CWRU-High-energy-Astrophysics-Lab/Auger_ekit/pmt-socket/DDP_pont1.xls

Sheet: Pont XP1805_D1 et sonde
Appareils utilisés |  |  | Résistance interne en Mohms | Résistance interne en Mohms | Impédance équivalente avec les 2 appareils en mohms
Multimètre Tektronix DMM916 |  |  | 10 | 10 | 75.074
Sonde Haute Tension Fluke 80K-6 |  |  | 75 | 75
Mesure sur dynodes | Résistance inter- dynodes en Mohms |  | Résistance appliquée sur les dynodes en Mohms | Résistance équivalente en Mohms avec sonde HT 80K-6 et multimètre 10Mohms | Résistance totale équivalente en Mohms | Courant parcouru dans le pont diviseur en µA | Potentiel à trouver en volts | U réel en volts | Sur schéma | Repère
K | 8.6499 |  | 0.0000 | 0.0000 | 25.4959 | 78.444 | 0.00 | 0.00 | 0 | K
G1 |  | 0.182 | 8.6499 | 7.7562 | 24.6022 | 81.293 | 630.53 | 678.53 | 678.5326268 | G1
D1 | 0.866 |  | 8.8319 | 7.9023 | 24.5663 | 81.412 | 643.34 | 692.81 | 692.8094321 | D1
G2 |  | 2.6 | 9.6979 | 8.5885 | 24.3865 | 82.013 | 704.36 | 760.74 | 760.7419232 | G2
D2 | 1.1 |  | 12.2979 | 10.5669 | 23.7649 | 84.158 | 889.29 | 964.70 | 964.6962845 | D2
D3 |  | 1.1 | 13.3979 | 11.3690 | 23.4670 | 85.226 | 968.93 | 1050.98 | 1050.984668 | D3
D4 | 1.3 |  | 14.4979 | 12.1513 | 23.1493 | 86.396 | 1049.82 | 1137.27 | 1137.273052 | D4
D5 |  | 2 | 15.7979 | 13.0515 | 22.7495 | 87.914 | 1147.41 | 1239.25 | 1239.250232 | D5
D6 | 2.2 |  | 17.7979 | 14.3871 | 22.0851 | 90.559 | 1302.88 | 1396.14 | 1396.138203 | D6
D7 |  | 2.6 | 19.9979 | 15.7915 | 21.2895 | 93.943 | 1483.50 | 1568.71 | 1568.71497 | D7
D8 | 2.4 |  | 22.5979 | 17.3696 | 20.2676 | 98.680 | 1714.03 | 1772.67 | 1772.669331 | D8
A |  | 0.498 | 24.9979 | 18.7535 | 19.2515 | 103.888 | 1948.26 | 1960.93 | 1960.934895 | A
HT |  |  | 25.4959 | 19.0324 | 19.0324 | 105.084 | 2000.00 | 2000.00 | 2000 | HT
R total | 25.4959
Tension HT | 2000
Courant | 78.44

Sheet: Pont XP1805_D1
Mesure entre dynodes | Résistance en Mohms | Résistance équivalente en Mohms avec multimètre de 10Mohms | Résistance totale équivalente en Mohms | Courant parcouru dans le pont diviseur en µA | Différence de potentiel à trouver en volts | U réel en volts | Sur schéma | Repère
K - G1 | 8.6499 | 4.6380 | 21.4840 | 93.092 | 431.77 | 678.53 | 678.5326268 | G1
G1 - D1 | 0.182 | 0.1787 | 25.4926 | 78.454 | 14.02 | 14.28 | 692.8094321 | D1
D1 - G2 | 0.866 | 0.7970 | 25.4269 | 78.657 | 62.69 | 67.93 | 760.7419232 | G2
G2 - D2 | 2.6 | 2.0635 | 24.9594 | 80.130 | 165.35 | 203.95 | 964.6962845 | D2
D2 - D3 | 1.1 | 0.9910 | 25.3869 | 78.781 | 78.07 | 86.29 | 1050.984668 | D3
D3 - D4 | 1.1 | 0.9910 | 25.3869 | 78.781 | 78.07 | 86.29 | 1137.273052 | D4
D4 - D5 | 1.3 | 1.1504 | 25.3463 | 78.907 | 90.78 | 101.98 | 1239.250232 | D5
D5 - D6 | 2 | 1.6667 | 25.1626 | 79.483 | 132.47 | 156.89 | 1396.138203 | D6
D6 - D7 | 2.2 | 1.8033 | 25.0992 | 79.684 | 143.69 | 172.58 | 1568.71497 | D7
D7 - D8 | 2.6 | 2.0635 | 24.9594 | 80.130 | 165.35 | 203.95 | 1772.669331 | D8
D8 - A | 2.4 | 1.9355 | 25.0314 | 79.900 | 154.64 | 188.27 | 1960.934895 | A
A- HT | 0.498 | 0.4744 | 25.4723 | 78.517 | 37.25 | 39.07 | 2000 | HT
R total | 25.4959
Tension HT | 2000
Courant | 78.44
Mesure entre les condensateurs | Dynodes | Différence de potentiel en volts
C1 | D6-D4 | 258.8651509
C2 | D8-D6 | 376.5311285
C3 | A-D8 | 188.2655643
C4 | D7-D5 | 329.4647375
C5 | A-D7 | 392.2199256
C6 | A-Masse | 1960.934895
C7 | D8-Masse | 1772.669331
C8 | A-Masse | 1960.934895
C9 | A-Masse | 1960.934895
