CWRU-High-energy-Astrophysics-Lab/Auger_ekit/pmt-socket/Pont diviseur.xls

Sheet: Pont PHOTONIS XP1805_D1 V3
Tension maximum en volts | Courant maximum en µA | Résistance totale en Mohms
2000.0 | 80.0 | 25.0
Dynodes | Ratio | Repère résistance | Valeur résistance
K - G1 | 10.00 | R1à R7 | 8.711
G1 - D1 | 0.20 | R8 | 0.174
D1 - G2 | 1.00 | R9 | 0.871
G2 - D2 | 3.00 | R10+R11 | 2.613
D2 - D3 | 1.25 | R12 | 1.089
D3 - D4 | 1.25 | R13 | 1.089
D4 - D5 | 1.50 | R14 | 1.307
D5 - D6 | 2.25 | R15+R16 | 1.960
D6 - D7 | 2.50 | R17+R18 | 2.178
D7 - D8 | 3.00 | R19+R20 | 2.613
D8 - A | 2.75 | R21+R22 | 2.395
A - HT |  | R23+R24 | 0.500
Ratio total | 28.70 | 0.871 | 25.00
Dynodes | Résistances en Mohms | Repère schéma | Ratio | Valeur Résistances en Mohms |  |  |  |  |  |  | Tension appliquée en volts
K - G1 | 8.6699 | R1à R7 | 10.011 | 0.0499 | 1.47 | 1.43 | 1.43 | 1.43 | 1.43 | 1.43 | 3.911 | 115.23 | 112.09 | 112.09 | 112.09 | 112.09 | 112.09
G1 - D1 | 0.181 | R8 | 0.21 | 0.181 |  |  |  |  |  |  | 14.19
D1 - G2 | 0.866 | R9 | 1.00 | 0.866 |  |  |  |  |  |  | 67.88
G2 - D2 | 2.60 | R10+R11 | 3.00 | 1.3 | 1.3 |  |  |  |  |  | 101.90 | 101.90
D2 - D3 | 1.10 | R12 | 1.27 | 1.1 | 1 |  |  |  |  |  | 86.22
D3 - D4 | 1.10 | R13 | 1.27 | 1.1 |  |  |  |  |  |  | 86.22
D4 - D5 | 1.30 | R14 | 1.50 | 1.3 |  |  |  |  |  |  | 101.90
D5 - D6 | 2.00 | R15+R16 | 2.31 | 1 | 1 |  |  |  |  |  | 78.39 | 78.39
D6 - D7 | 2.20 | R17+R18 | 2.54 | 1.1 | 1.1 |  |  |  |  |  | 86.22 | 86.22
D7 - D8 | 2.60 | R19+R20 | 3.00 | 1.3 | 1.3 |  |  |  |  |  | 101.90 | 101.90
D8 - A | 2.40 | R21+R22 | 2.77 | 1.2 | 1.2 |  |  |  |  |  | 94.06 | 94.06
A - HT | 0.50 | R23+R24 |  | 0.249 | 0.249 |  |  |  |  |  | 19.52 | 19.52
R Total | 25.515 | Ratio | 28.89
Courant en µA | 78.39

Sheet: Feuil1
Tension maximum en volts | Courant maximum en µA | Résistance totale en Mohms
2000.0 | 80.0 | 25.0
Dynodes | Ratio | Repère résistance | Valeur résistance
K - G1 | 10.00 | R1à R7 | 8.711
G1 - D1 | 0.20 | R8 | 0.174
D1 - G2 | 1.00 | R9 | 0.871
G2 - D2 | 3.00 | R10+R11 | 2.613
D2 - D3 | 1.25 | R12 | 1.089
D3 - D4 | 1.25 | R13 | 1.089
D4 - D5 | 1.50 | R14 | 1.307
D5 - D6 | 2.25 | R15+R16 | 1.960
D6 - D7 | 2.50 | R17+R18 | 2.178
D7 - D8 | 3.00 | R19+R20 | 2.613
D8 - A | 2.75 | R21+R22 | 2.395
A - HT |  | R23+R24 | 0.500
Ratio total | 28.70 | 0.871 | 25.00
Dynodes | Résistances en Mohms | Repère schéma | Ratio | Valeur Résistances en Mohms |  |  |  |  |  |  | Tension appliquée en volts
K - G1 | 8.6499 | R1à R7 | 9.988 | 0.0499 | 1.50 | 1.50 | 1.50 | 1.50 | 1.30 | 1.30 | 3.914 | 117.67 | 117.67 | 117.67 | 117.67 | 101.98 | 101.98
G1 - D1 | 0.182 | R8 | 0.21 | 0.182 |  |  |  |  |  |  | 14.28
D1 - G2 | 0.866 | R9 | 1.00 | 0.866 |  |  |  |  |  |  | 67.93
G2 - D2 | 2.60 | R10+R11 | 3.00 | 1.3 | 1.3 |  |  |  |  |  | 101.98 | 101.98
D2 - D3 | 1.10 | R12 | 1.27 | 1.1 | 1 |  |  |  |  |  | 86.29
D3 - D4 | 1.10 | R13 | 1.27 | 1.1 |  |  |  |  |  |  | 86.29
D4 - D5 | 1.30 | R14 | 1.50 | 1.3 |  |  |  |  |  |  | 101.98
D5 - D6 | 2.00 | R15+R16 | 2.31 | 1 | 1 |  |  |  |  |  | 78.44 | 78.44
D6 - D7 | 2.20 | R17+R18 | 2.54 | 1.1 | 1.1 |  |  |  |  |  | 86.29 | 86.29
D7 - D8 | 2.60 | R19+R20 | 3.00 | 1.3 | 1.3 |  |  |  |  |  | 101.98 | 101.98
D8 - A | 2.40 | R21+R22 | 2.77 | 1.2 | 1.2 |  |  |  |  |  | 94.13 | 94.13
A - HT | 0.50 | R23+R24 |  | 0.249 | 0.249 |  |  |  |  |  | 19.53 | 19.53
R Total | 25.496 | Ratio | 28.87
Courant en µA | 78.44
