CWRU-High-energy-Astrophysics-Lab/Auger_ekit/pmt-socket/embase_xp1805-v4.dxf

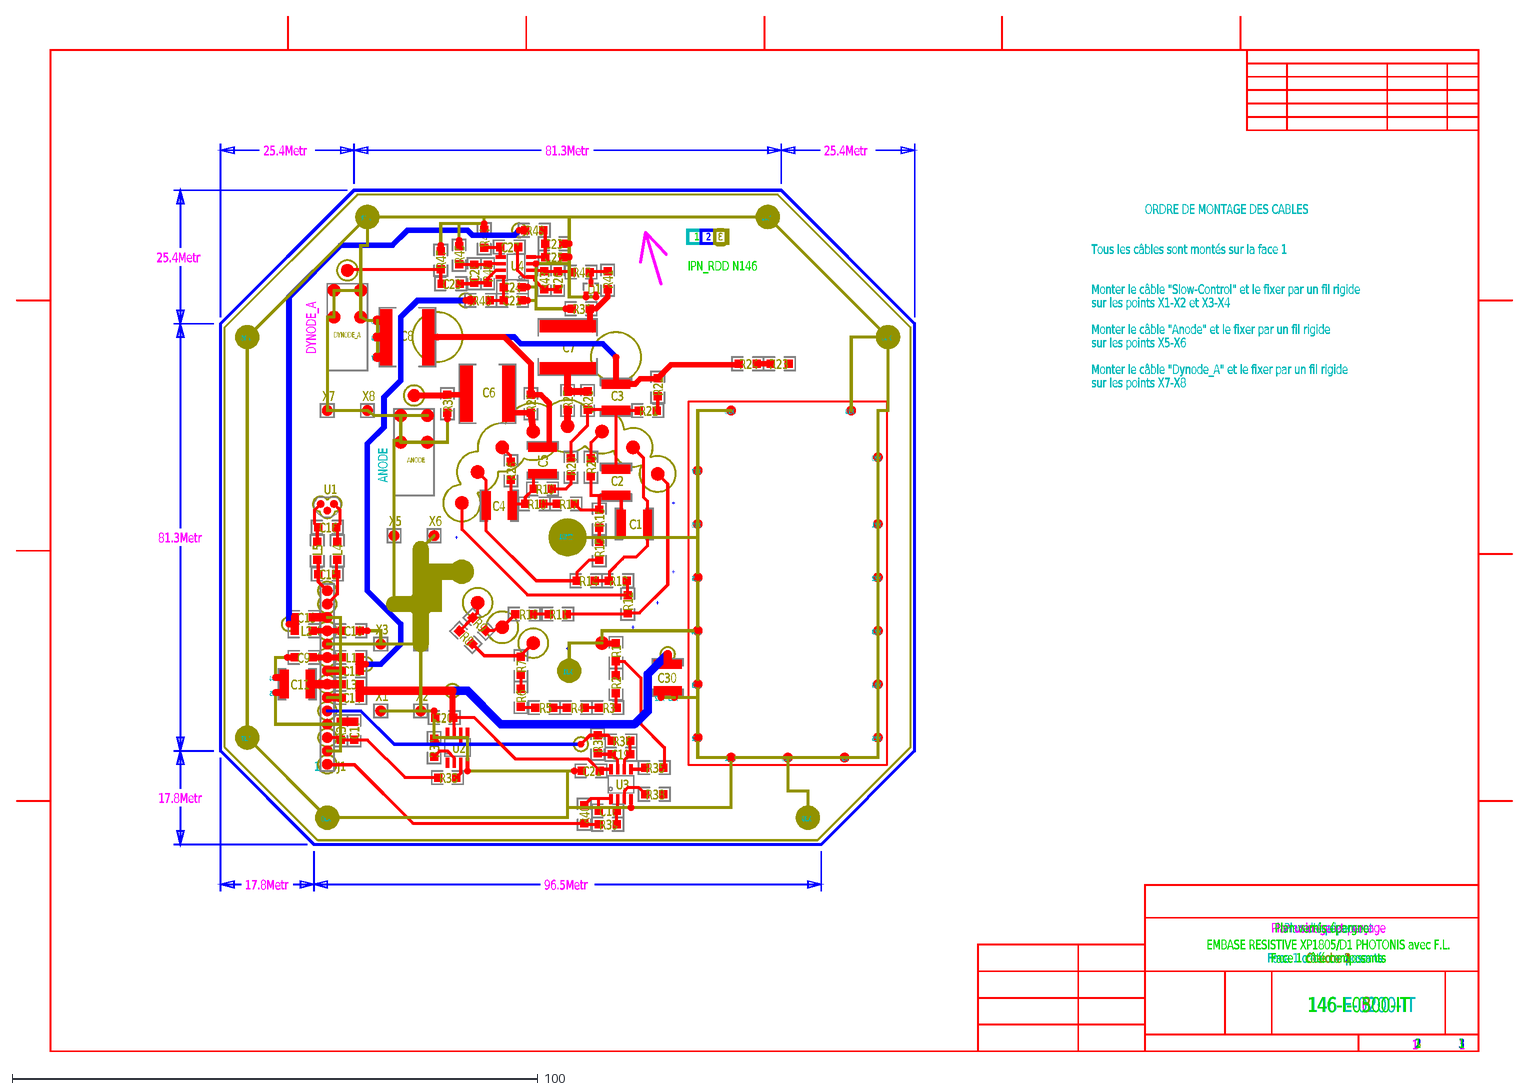
[picture p1: CAD file, 2021-10-01]
pmt-socket/embase_xp1805-v4.dxf
25.4Metr
81.3Metr
17.8Metr
96.5Metr
Plan d'équipement
Face 1 côté composants
146-E-0200-IT
3
EMBASE RESISTIVE XP1805/D1 PHOTONIS avec F.L.
Plan usinage et perçage
1
146-I-0300-IT
146-I-0600-IT
2
Couche 1
Couche 2
Couche 3
ANODE
DYNODE_A
ORDRE DE MONTAGE DES CABLES
Monter le câble "Slow-Control" et le fixer par un fil rigide
sur les points X1-X2 et X3-X4
Monter le câble "Anode" et le fixer par un fil rigide
sur les points X5-X6
Monter le câble "Dynode_A" et le fixer par un fil rigide
sur les points X7-X8
Tous les câbles sont montés sur la face 1
IPN_RDD N146
Plan vernis épargne
146-I-0500-IT
R1
R20
R29
R19
R8
R9
R10
R12
R13
R14
R15
R17
R23
R31
R21
R30
R27
R28
C15
U2
U3
R33
R34
R38
R35
L3
L1
L2
C14
C12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
