CWRU-High-energy-Astrophysics-Lab/Auger_ekit/pmt-socket/PS2010_1.pdf

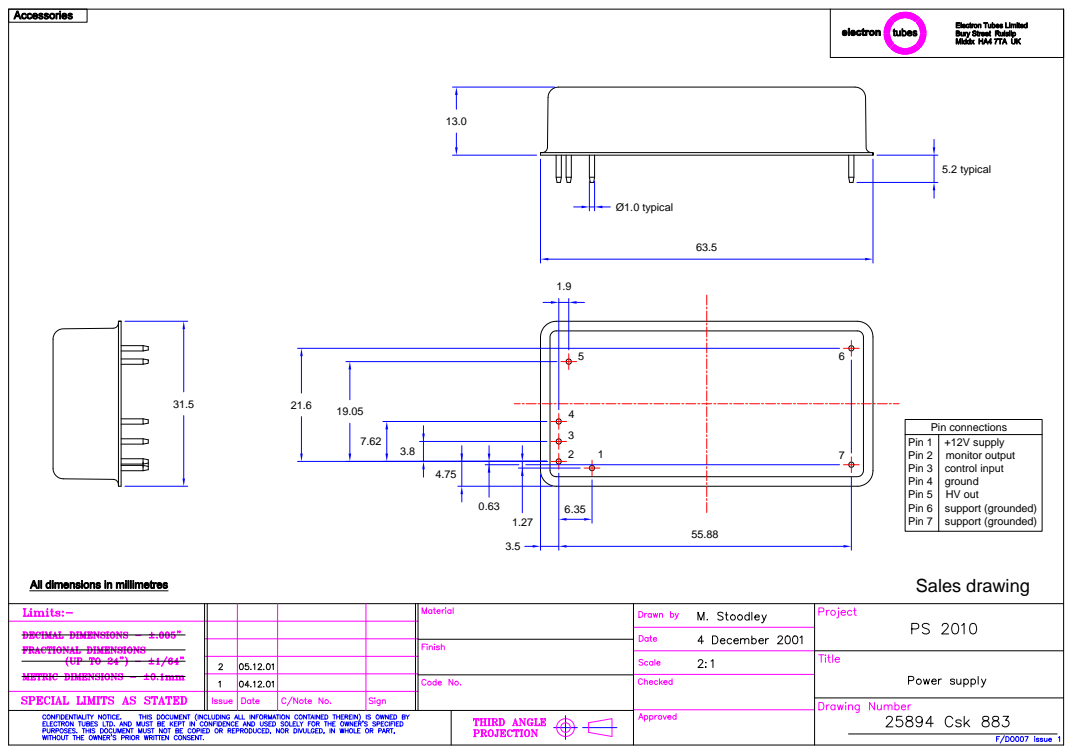
[picture p41: page 1]
5.2 typical; Pin connections Pin 1 Pin 2 Pin 3 Pin 4 Pin 5 Pin 6 Pin 7; +12V supply monitor output control input ground HV out support (grounded) support (grounded); Ø1.0 typical; Sales drawing
