CWRU-High-energy-Astrophysics-Lab/Auger_ekit/pmt-socket/PS2010_2.pdf

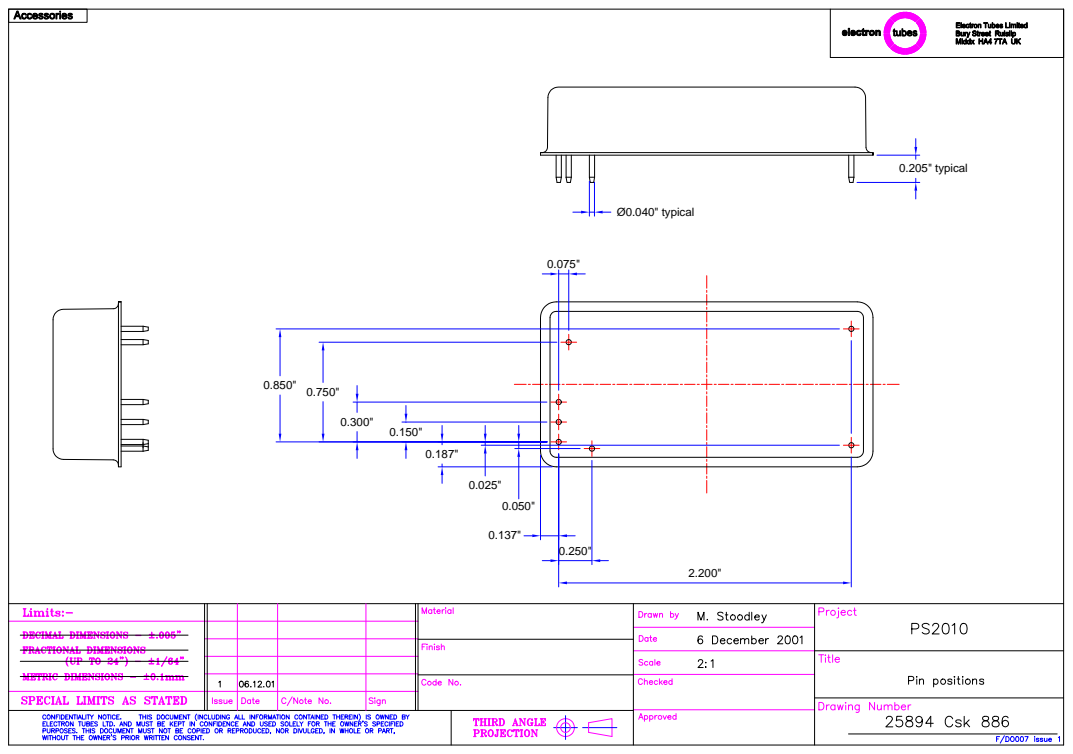
[picture p42: page 1]
Ø0.040" typical; 0.205" typical
