CWRU-High-energy-Astrophysics-Lab/Auger_ekit/(list of files, drawings)

Other design files:
pmt-socket/Embase_XP1805-V4.pcb
